dwaskevich/MIDI_Traffic_Monitor/hardware/midi traffic monitor - allegro 3d view - top - Rev_A.PNG

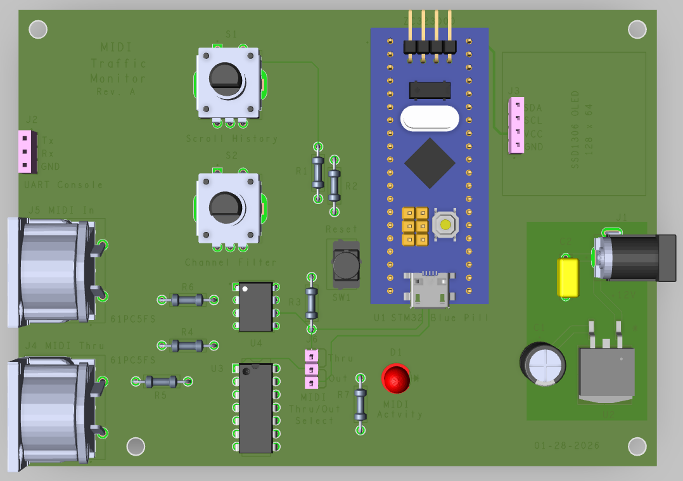
hardware/midi traffic monitor - allegro 3d view - top - Rev_A.PNG
