dwaskevich/MIDI_Traffic_Monitor/hardware/midi_traffic_monitor_allegro_3d_view_isometric.PNG

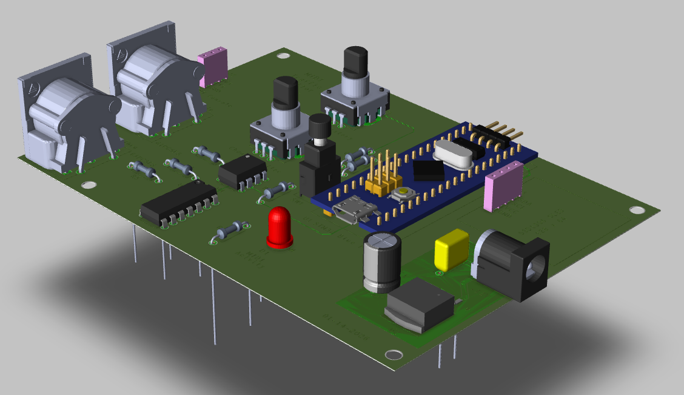
hardware/midi_traffic_monitor_allegro_3d_view_isometric.PNG
