dwaskevich/MIDI_Traffic_Monitor/hardware/MIDI_schematic_Rev_A.pdf

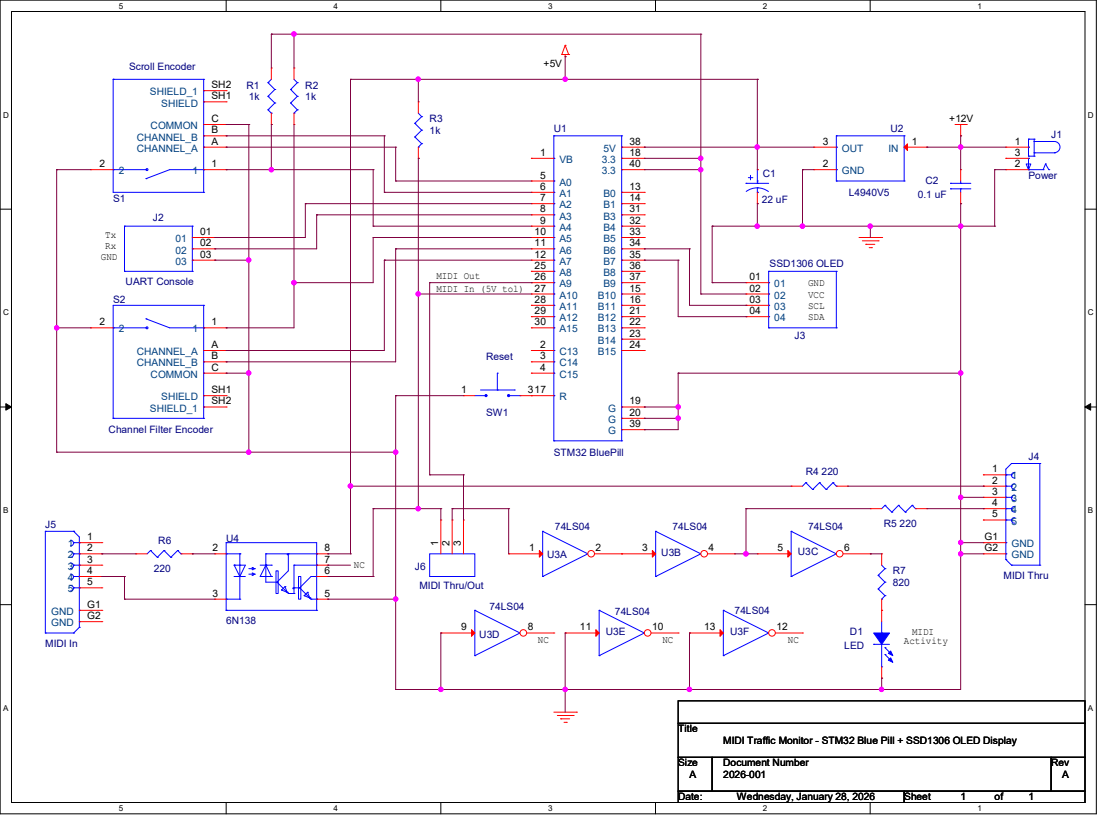
[picture p7: page 1]

MIDI Traffic Monitor - STM32 Blue Pill + SSD1306 OLED Display
