dwaskevich/MIDI_Traffic_Monitor/hardware/MIDI_schematic.pdf

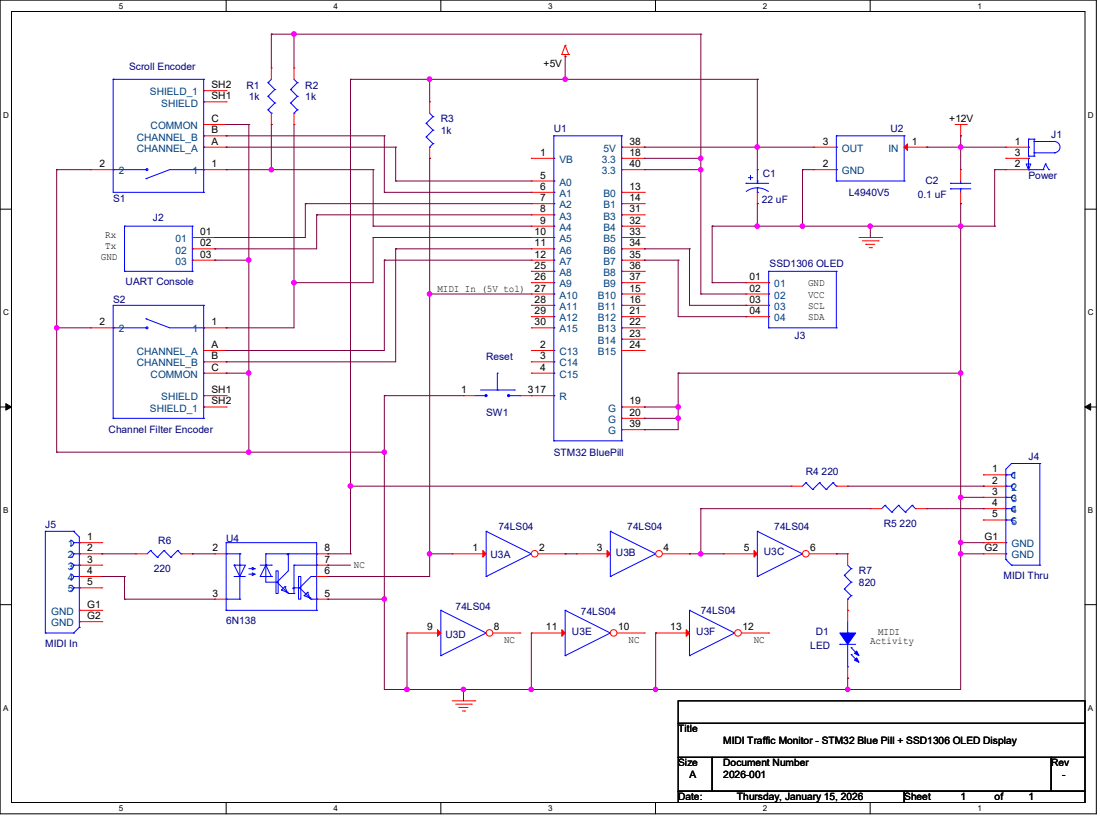
[picture p8: page 1]

MIDI Traffic Monitor - STM32 Blue Pill + SSD1306 OLED Display
