dwaskevich/MIDI_Traffic_Monitor/Core/Src/main.c

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
/* Includes ------------------------------------------------------------------*/
#include "main.h"

/* USER CODE BEGIN Includes */
#include "stdio.h"
#include "stdbool.h"
#include "scheduler.h"
#include "tasks.h"
#include "display.h"
#include "filter_channels.h"
#include "session.h"
#include "midi.h"
#include "app_state_machine.h"
#include "ui.h"

/* USER CODE END Includes */

I2C_HandleTypeDef hi2c1;

TIM_HandleTypeDef htim2;
TIM_HandleTypeDef htim3;
TIM_HandleTypeDef htim4;

UART_HandleTypeDef huart1;
UART_HandleTypeDef huart2;

/* USER CODE BEGIN PV */
volatile uint32_t ms_counter = 0;

volatile uint16_t fifo_count = 0; /* FIFO utilization */
uint8_t rxBuffer[80]; /* may not be necessary, single variable may be enough ... needs testing */
volatile uint16_t headPointer = 0, tailPointer = 0; /* FIFO head and tail pointers */

/* optimize uart fifo storage ... pack structure with 24-bit byte_timestamp  */
typedef struct __attribute__((packed)) {
	uint8_t  rx_byte;
	uint32_t byte_timestamp : 24;
} rxData;
volatile rxData rxFIFO[UART_FIFO_SIZE]; /* Rx FIFO ... no rollover protection, older characters overwritten if FIFO fills */

volatile uint32_t midi_timestamp = 0, midi_delta_timestamp = 0;
uint16_t newest_message_encoder_value; /* encoder value for newest message ... will be used to automatically switch from SCROLL to LIVE mode */
stc_midi *ptr_packet;
volatile bool timeoutFlag = false;

/* USER CODE END PV */

void SystemClock_Config(void);
static void MX_GPIO_Init(void);
static void MX_I2C1_Init(void);
static void MX_USART1_UART_Init(void);
static void MX_TIM2_Init(void);
static void MX_USART2_UART_Init(void);
static void MX_TIM3_Init(void);
static void MX_TIM4_Init(void);
/* USER CODE BEGIN PFP */
void HAL_SYSTICK_Callback(void);
void heartbeat_task(void);
void read_encoders(void);
void setup_tasks(void);

/* USER CODE END PFP */

/**
  * @brief  The application entry point.
  * @retval int
  */
int main(void)
{

  /* USER CODE BEGIN 1 */
  uint8_t rx_data;
  uint32_t rx_data_timestamp;

  /* USER CODE END 1 */

  /* MCU Configuration--------------------------------------------------------*/

  /* Reset of all peripherals, Initializes the Flash interface and the Systick. */
  HAL_Init();

  /* Configure the system clock */
  SystemClock_Config();

  /* Initialize all configured peripherals */
  MX_GPIO_Init();
  MX_I2C1_Init();
  MX_USART1_UART_Init();
  MX_TIM2_Init();
  MX_USART2_UART_Init();
  MX_TIM3_Init();
  MX_TIM4_Init();
  /* USER CODE BEGIN 2 */

  display_init();
  display_splash_screen();

  HAL_Delay(5000);

  /* initialize OLED display and paint opening UI screens */
  display_start_screen();

  // Start the encoder interfaces (TIM2 - scroll encoder, TIM3 - channel filter encoder)
  HAL_TIM_Encoder_Start(&htim2, TIM_CHANNEL_ALL);
  HAL_TIM_Encoder_Start(&htim3, TIM_CHANNEL_ALL);

  __HAL_TIM_CLEAR_IT(&htim4, TIM_FLAG_UPDATE);

  scheduler_init();
  tasks_init();

  printf("\r\n\n---- Application started. -------\r\n");
  printf("Number of history elements initialized = %d\r\n", ui_initialize_ui());
  printf("Number of OLED display lines = %d\r\n", SSD1306_HEIGHT / DISPLAY_DEFAULT_FONT.height - 1);

  HAL_UART_Receive_IT(&huart1, rxBuffer, 1); /* start UART in interrupt mode */
  printf("MIDI UART started.\r\n\n");

  newest_message_encoder_value = __HAL_TIM_GetCounter(&htim2); /* get current scroll encoder value */

  /* USER CODE END 2 */

  /* Infinite loop */
  /* USER CODE BEGIN WHILE */
  while (1)
  {
	  /* check rxFIFO for incoming characters */
	  if(0 != fifo_count) /* if true, new data is available */
	  {
		  rx_data_timestamp = rxFIFO[tailPointer].byte_timestamp; /* retrieve timestamp from FIFO */
		  rx_data = rxFIFO[tailPointer++].rx_byte; /* retrieve new character from FIFO */
		  fifo_count--;
		  if(tailPointer >= UART_FIFO_SIZE) /* manage FIFO pointer rollover */
			  tailPointer = 0;

		  ptr_packet = midi_build_packet(rx_data, rx_data_timestamp); /* build full 3-byte packets, save pointer for later use */
	  }

	  if(midi_isPacketAvailable())
	  {
	      /* hand packet to ui for processing */
		  ui_process_midi_packet(ptr_packet);
	  }

	  if(true == timeoutFlag)
	  {
		  ui_fill_display();
		  timeoutFlag = false; /* clear the timer timeout interrupt flag */
	  }

    /* USER CODE END WHILE */

    /* USER CODE BEGIN 3 */
  }
  /* USER CODE END 3 */
}

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
/* USER CODE BEGIN 4 */

void HAL_SYSTICK_Callback(void) {
    ms_counter++;
    run_scheduled_tasks();
}

int __io_putchar(int ch) {
    HAL_UART_Transmit(&huart2, (uint8_t *)&ch, 1, HAL_MAX_DELAY);
    return ch;
}

void HAL_UART_RxCpltCallback(UART_HandleTypeDef *huart)
{
	if (huart->Instance == USART1)
	{
		fifo_count++;
		if(fifo_count > UART_FIFO_SIZE) /* check for FIFO rollover */
		{
			tailPointer = headPointer; /* fast forward tail pointer to catch up with head pointer */
			fifo_count = UART_FIFO_SIZE + 1; /* clamp count to prevent unnecessary "catch-up" latency on UI */
		}
		rxFIFO[headPointer].byte_timestamp = HAL_GetTick(); /* timestamp received byte */
		rxFIFO[headPointer++].rx_byte = rxBuffer[0]; /* place received character from UART in FIFO */

//		HAL_UART_Transmit(&huart2, rxBuffer, 1, HAL_MAX_DELAY); /* echo raw data to console */

		if(headPointer >= UART_FIFO_SIZE) /* manage headPointer rollover (new arrivals will overwrite older) */
			headPointer = 0;

		HAL_UART_Receive_IT(&huart1, rxBuffer, 1); /* restart UART Rx interrupt */
	}
}

/**
  * TIM4 - time-out timer
  *
  * @brief  Period elapsed callback in non blocking mode
  * @param  htim : TIM handle
  * @retval None
  */
void HAL_TIM_PeriodElapsedCallback(TIM_HandleTypeDef *htim)
{
	if(htim->Instance == TIM4)
	{
		timeoutFlag = true; /* set timeOut flag to indicate scroll screen should be updated */
		HAL_TIM_Base_Stop_IT(htim);
	}

}

/* USER CODE END 4 */
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
