dwaskevich/MIDI_Traffic_Monitor/Core/Inc/main.h

#define UART_FIFO_SIZE          (2048u)
#define LED_Pin GPIO_PIN_13
#define LED_GPIO_Port GPIOC
#define Scroll_Btn_Pin GPIO_PIN_4
#define Scroll_Btn_GPIO_Port GPIOA
#define Scroll_Btn_EXTI_IRQn EXTI4_IRQn
#define Filter_Btn_Pin GPIO_PIN_5
#define Filter_Btn_GPIO_Port GPIOA
#define Filter_Btn_EXTI_IRQn EXTI9_5_IRQn
