dwaskevich/MIDI_Traffic_Monitor/Core/Inc/tasks.h

/*
 * tasks.h
 *
 *  Created on: Dec 13, 2025
 *      Author: dwask
 */

#ifndef INC_TASKS_H_
#define INC_TASKS_H_

void tasks_init(void);  // Call this from main.c to register all tasks

#endif /* INC_TASKS_H_ */
