dwaskevich/MIDI_Traffic_Monitor/(commit log)

2025-12-31 updated splash screen, readme.md
    [bluepill.cfg]
2025-12-31 added background data arrival indicator to display while in scroll or filtered channel mode
2026-01-09 improved encoder pushbutton IRQ handling. adjusted history to 900 pages (SRAM utilization now 19,328 bytes).
2026-01-10 fixed MIDI arrival timestamps, adjusted size of history
    [main.c, midi.c, midi.h, ui.h]
2026-01-26 improved filter-by-channel search, updated README.md
2026-01-29 Rev A hardware - added jumper selection for future MIDI Out capability, fixed silk screen error on Console UART. Updated README
2026-02-13 optimized and balanced sram allocation for uart fifo and midi history, changed fifo_not_empty test to fifo_count, updated readme
2026-02-16 clamp fifo count UART_FIFO_SIZE on rollover to prevent unnecessary catch-up latency on UI display, fast-forward tail pointer to catch up with head pointer
    [main.c, ui.c]
